RoboSAX/eagle_anzeige/README.md

# eagle_anzeige
Anzeigeelemente für die Masterplatine der Spielfeldsteuerung
