RoboSAX/eagle_anzeige/parts/bom.ods

Part | Value | Device | Package | Reichelt
C1 | 100n | C-EUC0805 | C0805 | https://www.reichelt.de/Vielschicht-SMD-G0805/KEM-X7R0805-100N/3/index.html?ACTION=3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
C2 | 100n | C-EUC0805 | C0805
C3 | 100n | C-EUC0805 | C0805
D1 | TA20-11HWA | TA20-11HWA | TA20-11HWA | https://www.reichelt.de/Siebensegment-Anzeigen/TA-20-11-RT/3/index.html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
D2 | TA20-11HWA | TA20-11HWA | TA20-11HWA
- | 2 Stück gesamt für D1, D2 |  |  | https://www.reichelt.de/Buchsenleisten/BL-1X20G-2-54/3/index.html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
IC1 | UDN2981A | UDN2981A | DIL18 | https://www.reichelt.de/ICs-U-ZTK-/UDN-2981/3/index.html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
IC2 | UDN2981A | UDN2981A | DIL18
IC3 | 74HC595N | 74HC595N | DIL16 | https://www.reichelt.de/ICs-74HC-DIL/SN-74HC595N-TEX/3/index.html?ACTION=3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
IC4 | 74HC595N | 74HC595N | DIL16
IC5 | 74HC595N | 74HC595N | DIL16
ICL1 | ULN2003AN | ULN2003AN | DIL16 | https://www.reichelt.de/ICs-U-ZTK-/ULN-2003-AN/3/index.html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
JP1 | 8 Pin | PINHD-1X8/90 | 1X08/90 | https://www.reichelt.de/Platinen-Steckverbinder/PSS-254-8G/3/index.html?ACTION=3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
JP2 | 8 Pin | PINHD-1X8/90 | 1X08/90
X1 | 2 Pin |  |  | https://www.reichelt.de/RND-205-00045/3/index.html?ACTION=3&LA=55&ARTICLE=170233
L1 | red | LED-5MM | LED_5MM | https://www.reichelt.de/LEDs-5-mm/LED-5-10500-RT/3/index.html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
L2 | red | LED-5MM | LED_5MM
R1 | 56 | R-EU_R3216 | R3216 | https://www.reichelt.de/SMD-1206-von-0-bis-910-Ohm/RND-1206-1-56/3/index.html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
R3 | 10k | R-EU_M3216 | M3216 | https://www.reichelt.de/SMD-1206-von-1-bis-910-kOhm/RND-1206-1-10K/3/index.html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
R2 | 82 | R-EU_R0805 | R0805 | https://www.reichelt.de/SMD-0805-von-0-bis-910-Ohm/2/index.html
R4 | 82 | R-EU_R0805 | R0805
R5 | 82 | R-EU_R0805 | R0805
R6 | 82 | R-EU_R0805 | R0805
R7 | 82 | R-EU_R0805 | R0805
R8 | 82 | R-EU_R0805 | R0805
R9 | 82 | R-EU_R0805 | R0805
R10 | 82 | R-EU_R0805 | R0805
R11 | 82 | R-EU_R0805 | R0805
R12 | 82 | R-EU_R0805 | R0805
