RoboSAX/eagle_anzeige/spielfeld_anzeige.pdf

npn to mass; row driver.
same row selection for all 3 digits.

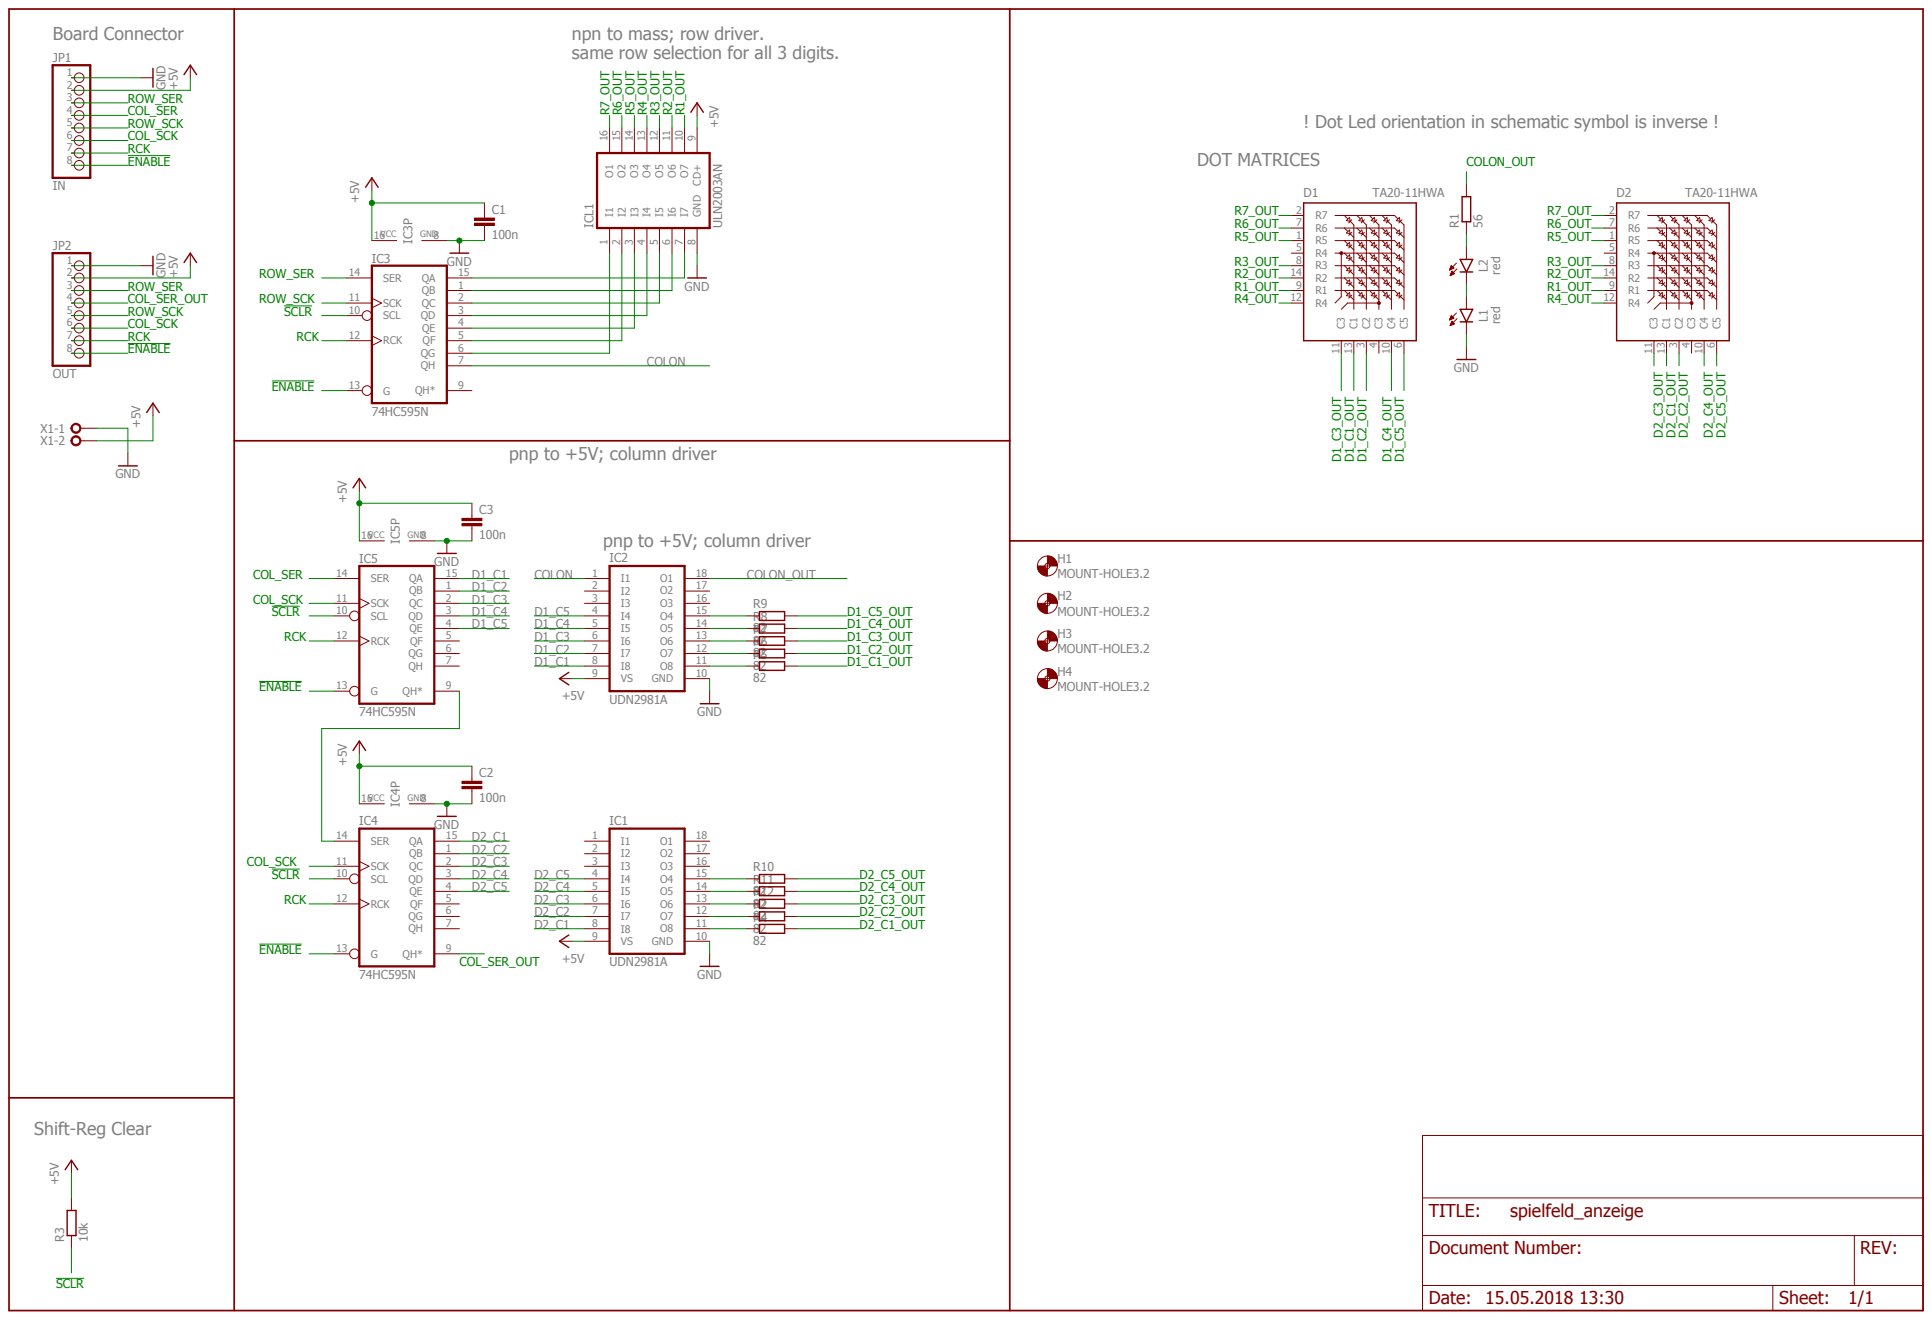
[picture p1: page 1]

! Dot Led orientation in schematic symbol is inverse !

pnp to +5V; column driver

Shift-Reg Clear

Document Number: | REV:

Date: 15.05.2018 13:30 | Sheet: 1/1

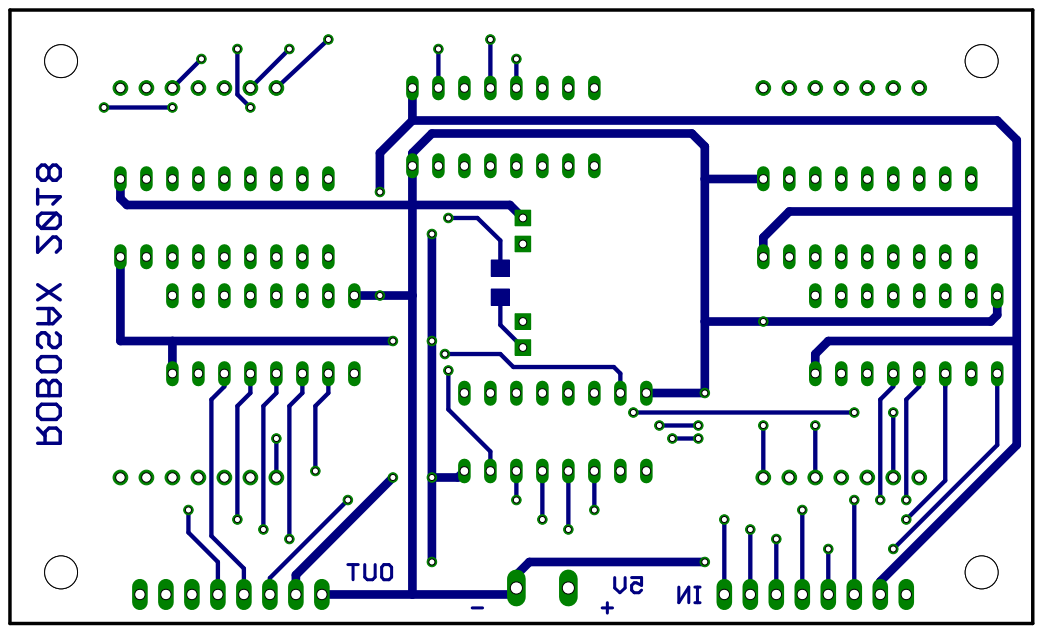
[picture p2: page 2]

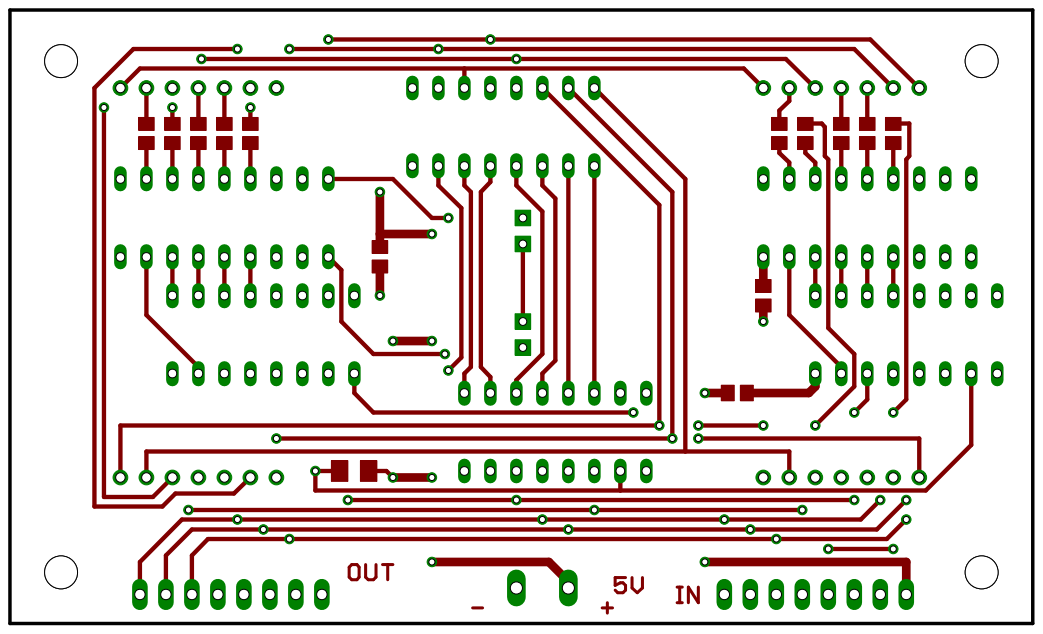
[picture p3: page 3]

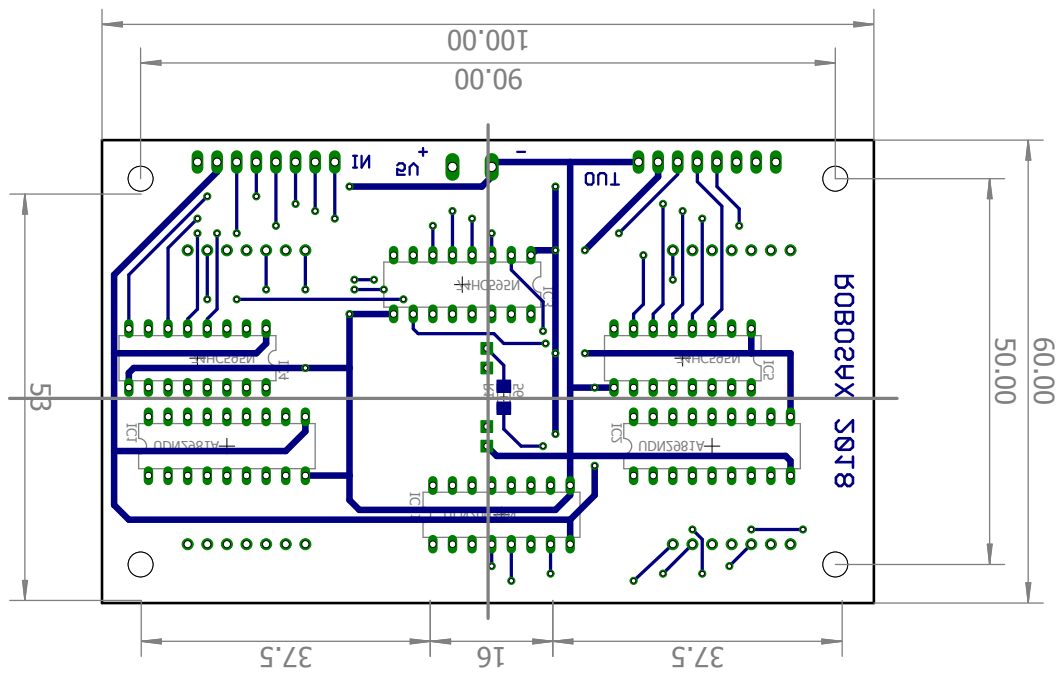
[picture p4: page 4]
ULN2003AN; UDN2981A; UDN2981A ⁵⁶; 74HC595N ICL1

60.00

50.00

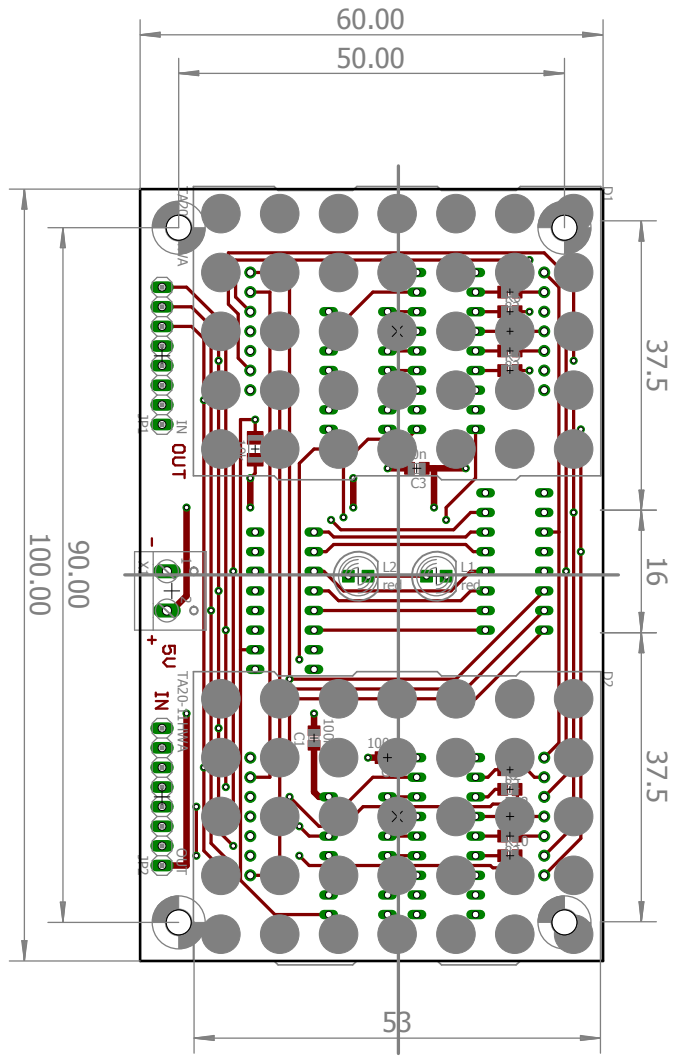
[picture p5: page 5]
