RoboSAX/eagle_anzeige/export/images/parts_bottom.pdf

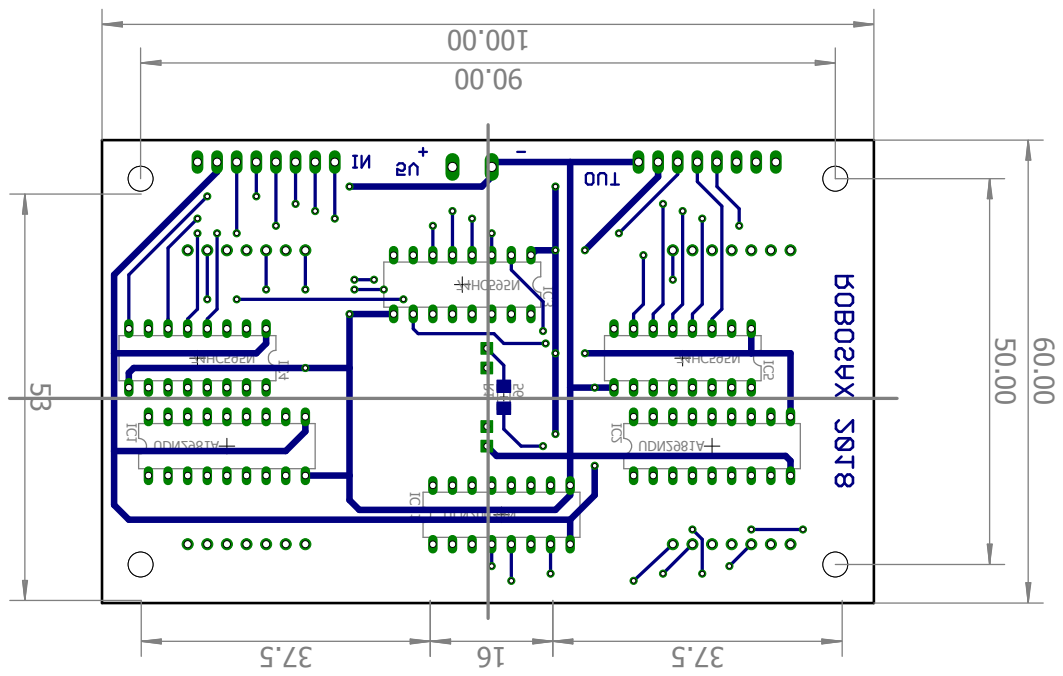
[picture p6: page 1]
ULN2003AN; UDN2981A; UDN2981A ⁵⁶; 74HC595N ICL1
