RoboSAX/eagle_anzeige/export/images/parts_top.pdf

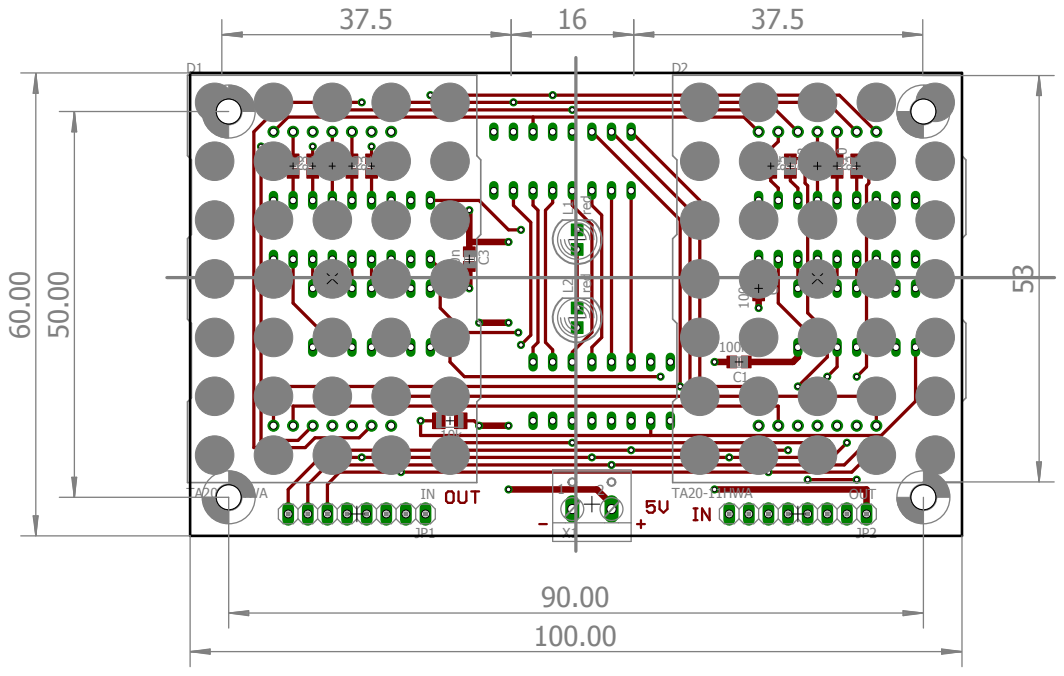
[picture p7: page 1]
