RoboSAX/eagle_anzeige/export/images/dimensions.pdf

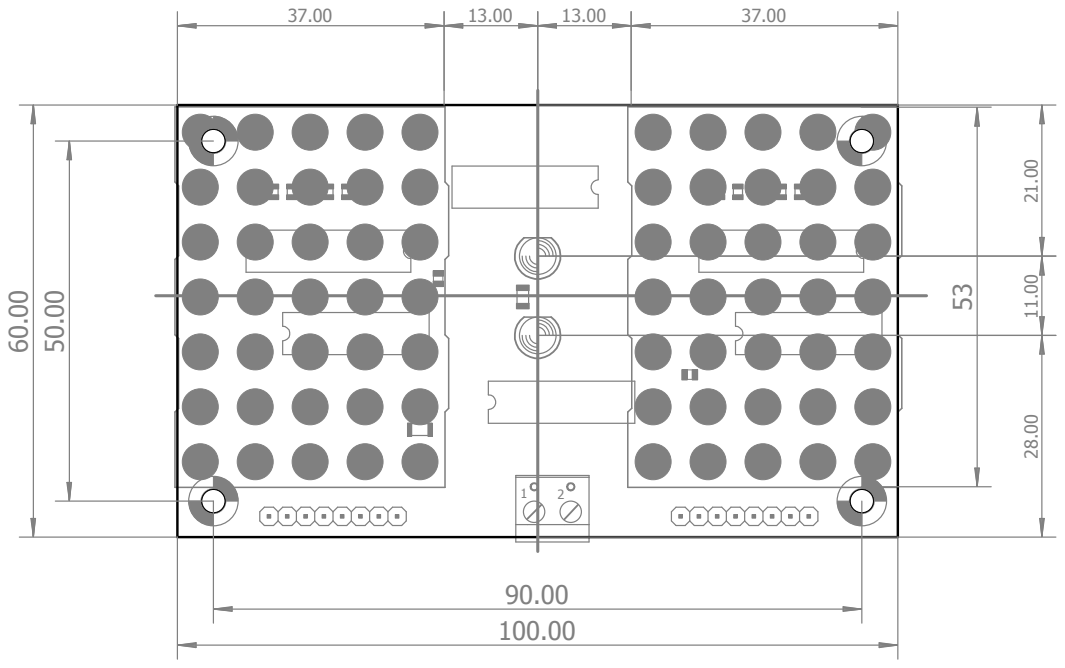
[picture p8: page 1]
