RoboSAX/eagle_anzeige/circuit/spielfeld_anzeige.brd

## EAGLE design circuit/spielfeld_anzeige.brd (2018-05-18)

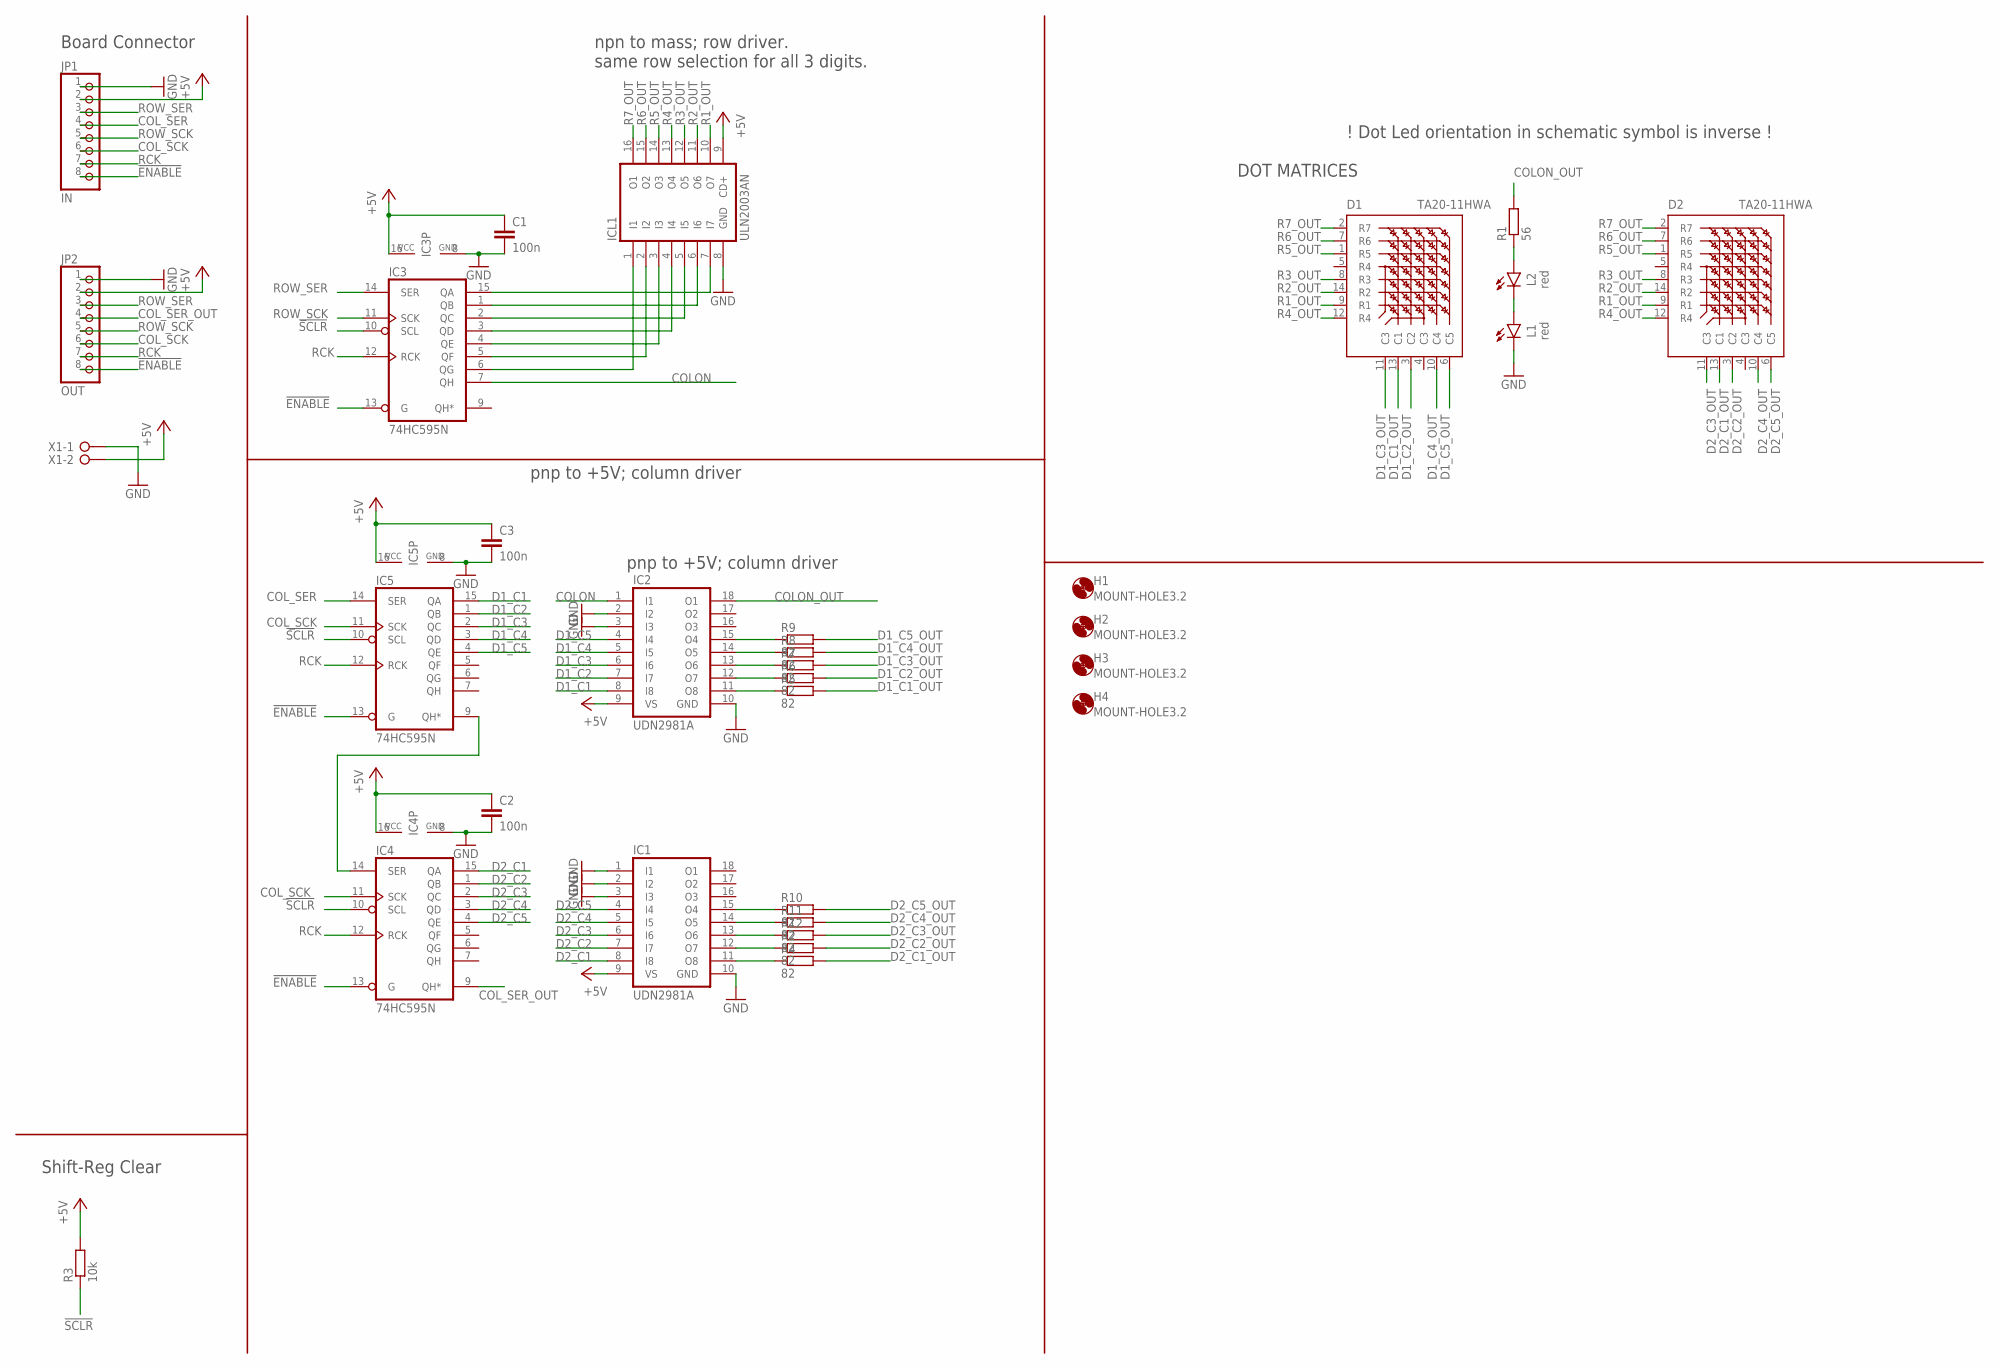
[picture p9: schematic spielfeld_anzeige.sch]

Parts:
C1, C2, C3: 100n; C0805
D1, D2: TA20-11HWA
H1, H2, H3, H4: MOUNT-HOLE3.2; 3,2
IC1, IC2: UDN2981A; DIL18
IC3, IC4, IC5: 74HC595N; DIL16
ICL1: ULN2003AN; DIL16
JP1: IN; 1X08
JP2: OUT; 1X08
L1, L2: red; LED_5MM
R1: 56; R3216
R2, R4, R5, R6, R7, R8, R9, R10, R11, R12: 82; R0805
R3: 10k; M3216
X1: W237-02P; W237-132

Connections:
!ENABLE!: IC3.13 (G), IC4.13 (G), IC5.13 (G), JP1.8, JP2.8
!SCLR!: IC3.10 (SCL), IC4.10 (SCL), IC5.10 (SCL), R3.1
+5V: C1.1, C2.1, C3.1, IC1.9 (VS), IC2.9 (VS), IC3.16 (VCC), IC4.16 (VCC), IC5.16 (VCC), ICL1.9 (CD+), JP1.2, JP2.2, R3.2, X1.2
COLON: IC2.1 (I1), IC3.7 (QH)
COLON_OUT: IC2.18 (O1), R1.2
COL_SCK: IC4.11 (SCK), IC5.11 (SCK), JP1.6, JP2.6
COL_SER: IC5.14 (SER), JP1.4
COL_SER_OUT: IC4.9 (QH*), JP2.4
D1_C1: IC2.8 (I8), IC5.15 (QA)
D1_C1_OUT: D1.13 (C1), R5.2
D1_C2: IC2.7 (I7), IC5.1 (QB)
D1_C2_OUT: D1.3 (C2), R6.2
D1_C3: IC2.6 (I6), IC5.2 (QC)
D1_C3_OUT: D1.11 (C3), R7.2
D1_C4: IC2.5 (I5), IC5.3 (QD)
D1_C4_OUT: D1.10 (C4), R8.2
D1_C5: IC2.4 (I4), IC5.4 (QE)
D1_C5_OUT: D1.6 (C5), R9.2
D2_C1: IC1.8 (I8), IC4.15 (QA)
D2_C1_OUT: D2.13 (C1), R4.2
D2_C2: IC1.7 (I7), IC4.1 (QB)
D2_C2_OUT: D2.3 (C2), R2.2
D2_C3: IC1.6 (I6), IC4.2 (QC)
D2_C3_OUT: D2.11 (C3), R12.2
D2_C4: IC1.5 (I5), IC4.3 (QD)
D2_C4_OUT: D2.10 (C4), R11.2
D2_C5: IC1.4 (I4), IC4.4 (QE)
D2_C5_OUT: D2.6 (C5), R10.2
GND: C1.2, C2.2, C3.2, IC1.1 (I1), IC1.2 (I2), IC1.3 (I3), IC1.10 (GND), IC2.2 (I2), IC2.3 (I3), IC2.10 (GND), IC3.8 (GND), IC4.8 (GND), IC5.8 (GND), ICL1.8 (GND), JP1.1, JP2.1, L1.K (C), X1.1
unnamed: L1.A, L2.K (C)
unnamed: IC2.11 (O8), R5.1
unnamed: IC2.12 (O7), R6.1
unnamed: IC2.13 (O6), R7.1
unnamed: IC2.14 (O5), R8.1
unnamed: IC2.15 (O4), R9.1
unnamed: IC1.15 (O4), R10.1
unnamed: IC3.15 (QA), ICL1.7 (I7)
unnamed: IC3.1 (QB), ICL1.6 (I6)
unnamed: IC3.2 (QC), ICL1.5 (I5)
unnamed: IC3.3 (QD), ICL1.4 (I4)
unnamed: IC3.4 (QE), ICL1.3 (I3)
unnamed: L2.A, R1.1
unnamed: IC1.14 (O5), R11.1
unnamed: IC1.13 (O6), R12.1
unnamed: IC1.12 (O7), R2.1
unnamed: IC1.11 (O8), R4.1
unnamed: IC3.5 (QF), ICL1.2 (I2)
unnamed: IC4.14 (SER), IC5.9 (QH*)
unnamed: IC3.6 (QG), ICL1.1 (I1)
R1_OUT: D1.9 (R1), D2.9 (R1), ICL1.10 (O7)
R2_OUT: D1.14 (R2), D2.14 (R2), ICL1.11 (O6)
R3_OUT: D1.8 (R3), D2.8 (R3), ICL1.12 (O5)
R4_OUT: D1.12 (R4), D2.12 (R4), ICL1.13 (O4)
R5_OUT: D1.1 (R5), D2.1 (R5), ICL1.14 (O3)
R6_OUT: D1.7 (R6), D2.7 (R6), ICL1.15 (O2)
R7_OUT: D1.2 (R7), D2.2 (R7), ICL1.16 (O1)
RCK: IC3.12 (RCK), IC4.12 (RCK), IC5.12 (RCK), JP1.7, JP2.7
ROW_SCK: IC3.11 (SCK), JP1.5, JP2.5
ROW_SER: IC3.14 (SER), JP1.3, JP2.3

Notes on the sheet:
npn to mass; row driver. same row selection for all 3 digits.
pnp to +5V; column driver
! Dot Led orientation in schematic symbol is inverse !
DOT MATRICES
Board Connector
Shift-Reg Clear

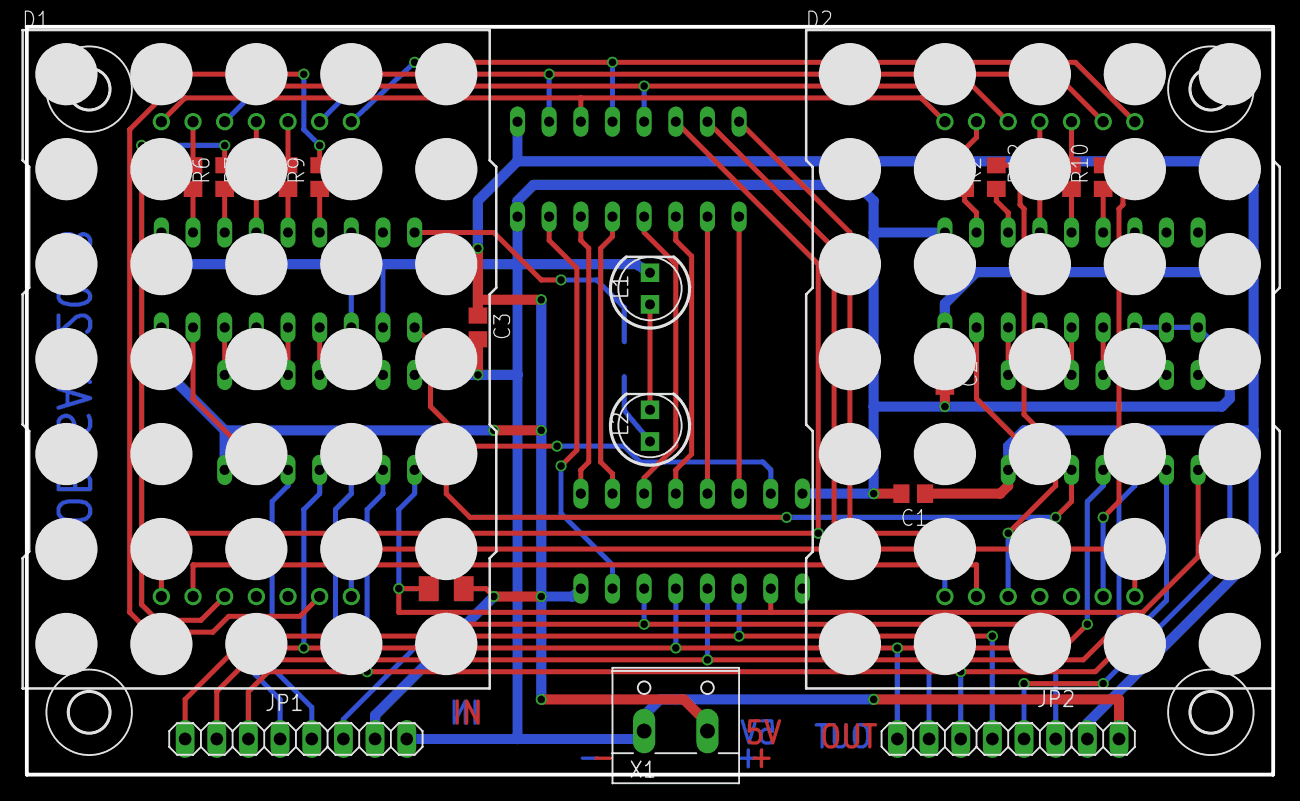
[picture p10: board spielfeld_anzeige.brd from above]

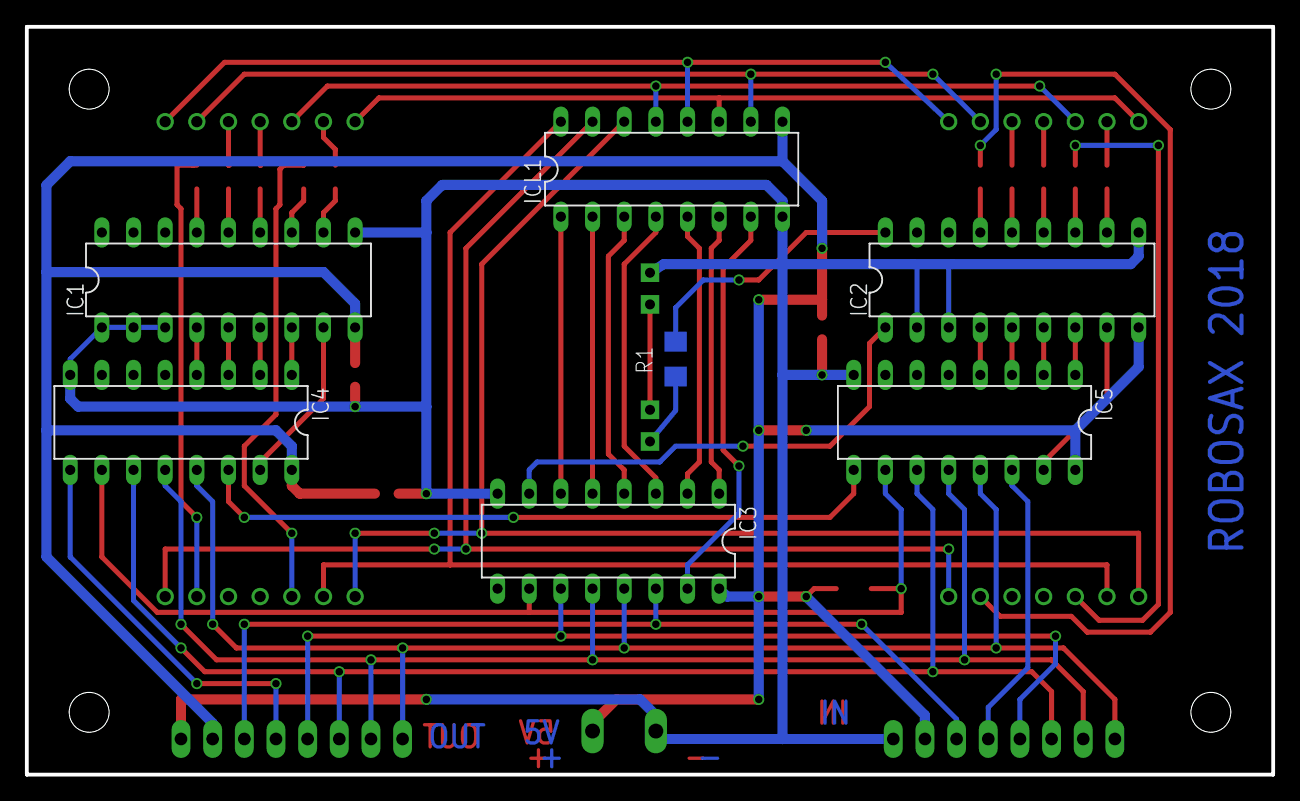
[picture p11: board spielfeld_anzeige.brd from below]

Board: 2 copper layers, 100.0 x 60.0 mm, 32 parts (7 on the bottom side), 59 nets.
