RoboSAX/eagle_anzeige/(commit log)

2018-03-01 inital commit
    [bom.ods, spielfeld_anzeige.brd, spielfeld_anzeige.sch]
2018-03-13 Schematic mit 3 Digits fertig
    [spielfeld_anzeige.brd, spielfeld_anzeige.sch]
2018-03-13 Reduced to 2 digits on board. Bom updated.
    [bom.ods, spielfeld_anzeige.brd, spielfeld_anzeige.sch]
2018-03-18 PCB design finished with tht parts on backside of board
    [bom.ods, spielfeld_anzeige.brd, spielfeld_anzeige.sch]
2018-04-27 added measurements to layout added exported images and global pdf
    [spielfeld_anzeige.brd]
2018-05-09 Revision due to Pete and Leander on 30.04.2018
    [bom.ods, reichelt-warenkorb.csv, spielfeld_anzeige.brd, spielfeld_anzeige.sch]
2018-05-09 Changed Layout (in Progress)
    Updated Eagle-Borad and Schematic
    - Reorganize the outputs of the FFs
    - Move Colon to FF for Rows
    - Change resistors to 0805 and 82 Ohm
    - Put all devices in Layout back to 50 mil grid
    - startet layout from scratch
    [spielfeld_anzeige.brd, spielfeld_anzeige.sch]
2018-05-09 Layout fertig
    [spielfeld_anzeige.brd, spielfeld_anzeige.sch]
2018-05-15 Doku Update
    BOM and Layout Doku updated
    [bom.ods]
2018-05-16 Korrekturen Layout
    LEDs ins mm-Raster zurückgesetzt.
    Maßangaben korrigiert.
    Die freien Eingänge der Treiber-ICs mit GND verbunden.
    [spielfeld_anzeige.brd, spielfeld_anzeige.sch]
2018-05-18 moved exported images (circuit, layout) to "export/images/"
2018-05-18 minor bugfixes
    [spielfeld_anzeige.brd, spielfeld_anzeige.sch]
2018-05-18 adde files for elecrow
    [spielfeld_anzeige.GBL, spielfeld_anzeige.GBO, spielfeld_anzeige.GBP, spielfeld_anzeige.GBS, spielfeld_anzeige.GTL, spielfeld_anzeige.GTO, spielfeld_anzeige.GTP, spielfeld_anzeige.GTS]
2018-05-18 changed structure of directories
    [bom.ods, reichelt-warenkorb.csv, spielfeld_anzeige.brd, spielfeld_anzeige.sch]
